Iarush/A-pad/README.md

# A-pad
A  custom Macropad with a special A-shaped keypad

## Specs
8 Mx Cherry Keys
EC11 Rotary Encoder
0.91" OLED Display
Seeed XIAO RP2040 Microcontroller
Custom-made PCB
Custom-made case and plates

## CAD Model

The Case is constructed using the sandwhich plating method. 3 plates were made. A bottom plate where screws are added, a middle frame amidst which the PCB rests, and finally a top switchplate for an aestheic look tht hides the screws.
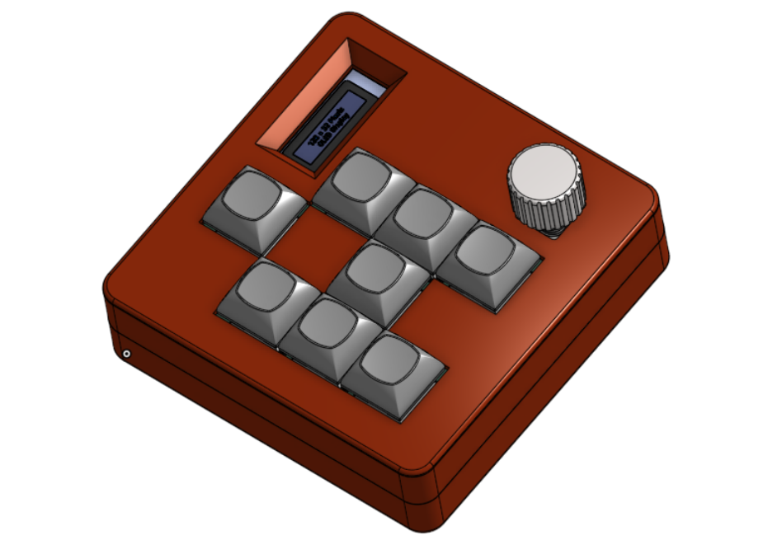
[picture p1: Images/CAD.png]
CAD Model


### Unique Features

- Switchplate is deeply bezeled aroung the OLED to allow easier viewability
- An "island" is created at the center of the A which is compeletely seperate from other parts of the switchplate but is secured with an M3 screw.
- Rotary Encoder top is also a CAD Model
CAD was made in Onshape

## PCB Schematic

The schematic was created in KICAD with the guidance of this Joe Scotto video on matrix wiring: [Video](https://www.youtube.com/watch?v=8WXpGTIbxlQ&t=787s)
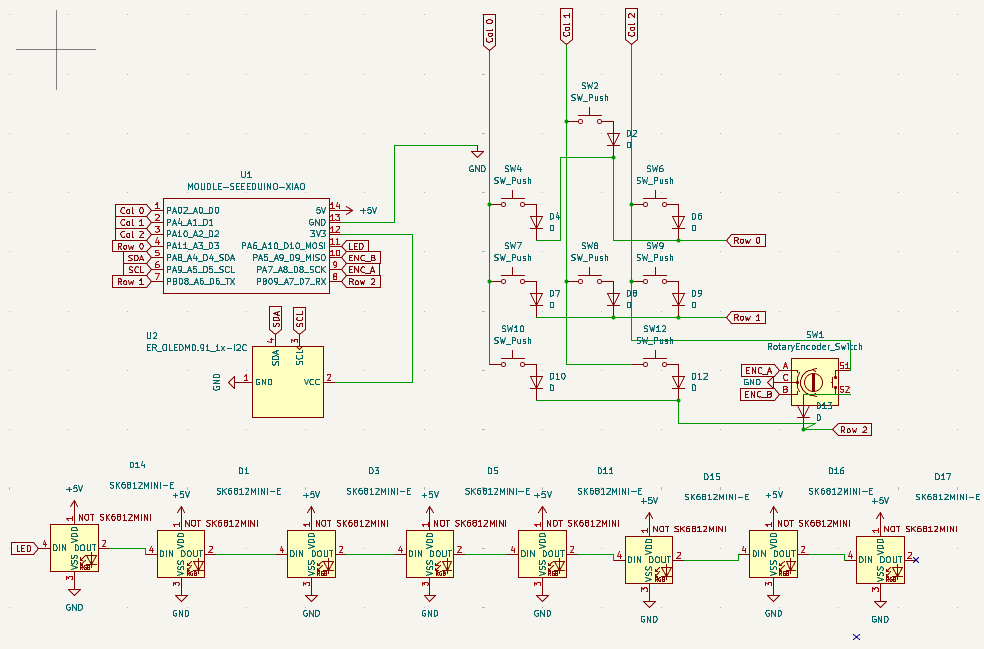
[picture p2: Images/Schematic.png]
Schematic Model


## PCB

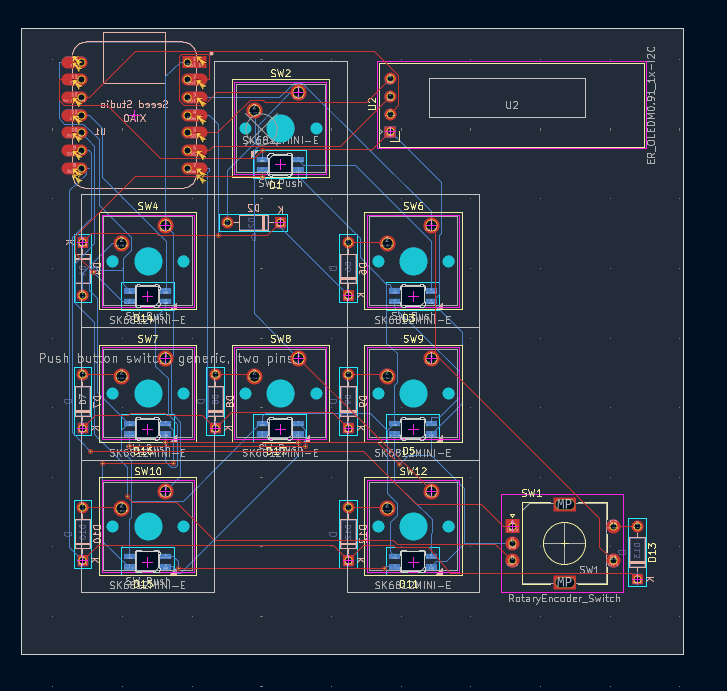
[picture p3: Images/PCB.png]
PCB Model


## Firmware Overview

This hackpad uses [KMK](https://github.com/KMKfw/kmk_firmware) firmware (CircuitPython). The firmware is [Production/main.py](Production/main.py).

- The 8 keys are wired as a 3x3 diode matrix (the encoder push button is the 9th spot)
- Keys: copy / play-pause / paste on top, undo / save / redo on the crossbar, previous / next track on the legs
- The rotary encoder changes volume, press to mute
- The 8 SK6812 MINI-E LEDs run a breathing rainbow
- The OLED shows the A-Pad name and the encoder controls
