Iarush/A-pad/BOM.csv

Item | Quantity | Component | Description / Notes | Included in HackPad Kit
1 | 1 | Seeed Studio XIAO RP2040 | Main microcontroller (U1) | Yes
2 | 1 | 0.91 inch SSD1306 OLED Display | 128x32 I2C screen (U2); pinout GND-VCC-SCL-SDA | Yes
3 | 1 | EC11 Rotary Encoder | Rotary encoder with push switch (SW1); volume control | Yes
4 | 8 | MX-Style Mechanical Switches | Keyswitches of choice (SW2/SW4/SW6-SW10/SW12) | Yes
5 | 8 | Blank DSA Keycaps | White keycaps | Yes
6 | 8 | SK6812 MINI-E RGB LEDs | Reverse-mount addressable LEDs (D1/D3/D5/D11/D14-D17) | Yes
7 | 9 | 1N4148 Diodes | Through-hole diodes for the 3x3 key matrix | Yes
8 | 6 | M3x16mm Screws | Enclosure fasteners | Yes
9 | 6 | M3x5x4mm Heatset Inserts | Brass threaded inserts for the case | Yes
10 | 1 | Custom PCB | Gerbers in Production/Gerbers.zip; ordered from JLCPCB | No
11 | 1 | 3D Printed Case | Bottom Tray / Frame / Switch Plate / Plate Island / Encoder Knob (STEP files in Production) | No
12 | 1 | Soldering Iron Station | Required for assembly (320-350 C) | No
13 | 1 | Printing Legion Grant | $8 in credit for Printing Legion | No
14 | 1 | Hackpad PCB Grant | $10 in credit for JLCPCB | No
