Iarush/A-pad/CAD/Full Assembly.step

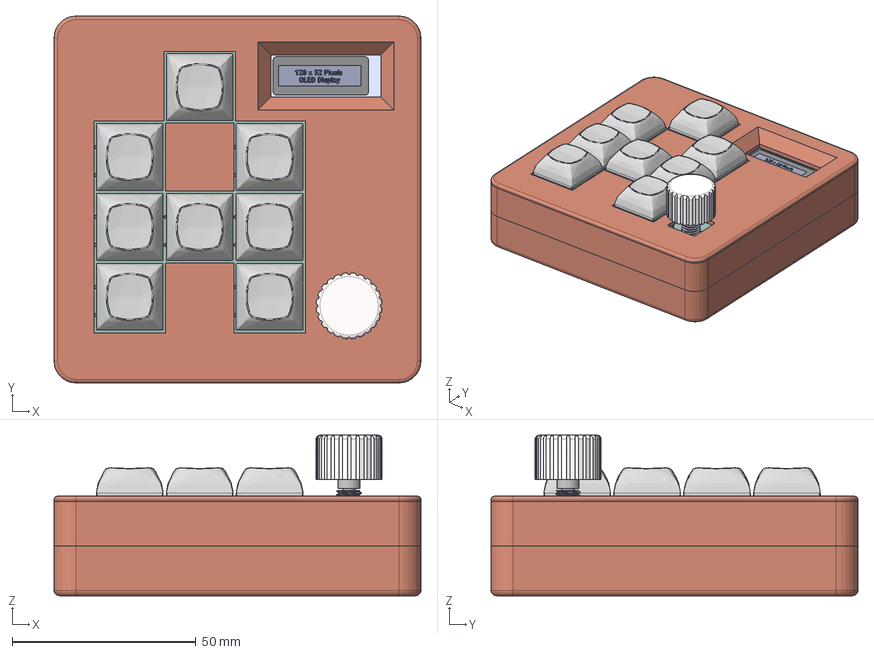
[picture p4: CAD file, 2026-10-13]
CAD/Full Assembly.step
100.0 x 100.0 x 43.7 mm
M3x16 Button Head Screw (ISO 7380) x 6
M3 Heat-Set Insert 4.7 x 4 x 6
Encoder Knob
Plate Island
Switch Plate
Frame
Bottom Tray
D_DO-35_SOD27_P7.62mm_Horizontal x 18
MX Mount v1 x 8
HackPad_PCB
Pin2 x 8
Pin4 x 8
Pin3 x 8
Pin1 x 8
EC11 v3 x 6
SW_Cherry_MX_PCB_cp x 56
smd_button v3
smd_button v3(Mirror)
DOUT
DIN
VDD
VSS
type-c v2 x 24
0603 Resistor_001 x 6
0603 Capacitor_004 x 6
0603 Capacitor_002 x 6
0603 Capacitor_005 x 6
0603 Resistor_003 x 6
0603 Resistor_005 x 6
Surface Mount Transistor_001 x 8
0603 Capacitor_008 x 6
1x4 Male Header_001 x 10
0603 Resistor_004 x 6
0603 Capacitor_001 x 6
0603 Capacitor_003 x 6
0603 Resistor_002 x 6
0603 Capacitor_006 x 6
0603 Capacitor_007 x 6
