Iarush/A-pad/Production/Switch Plate.step

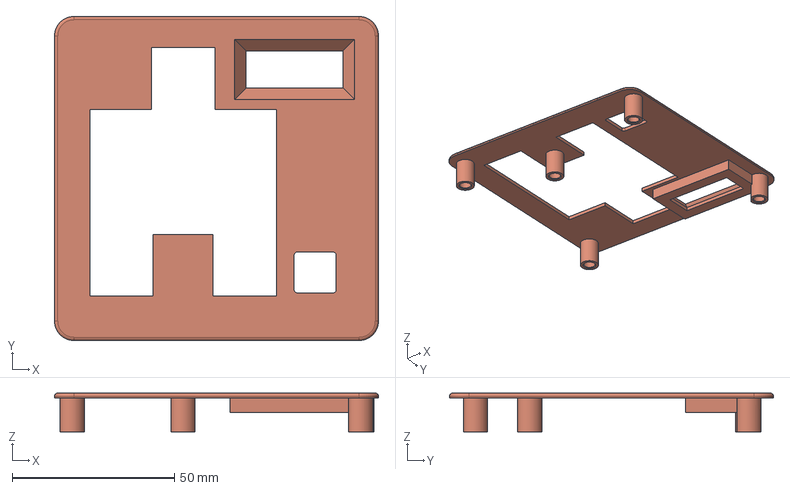
[picture p5: CAD file, 2026-11-08]
Production/Switch Plate.step
100.0 x 100.0 x 12.0 mm
