Iarush/A-pad/CAD/HackPad_with_parts.step

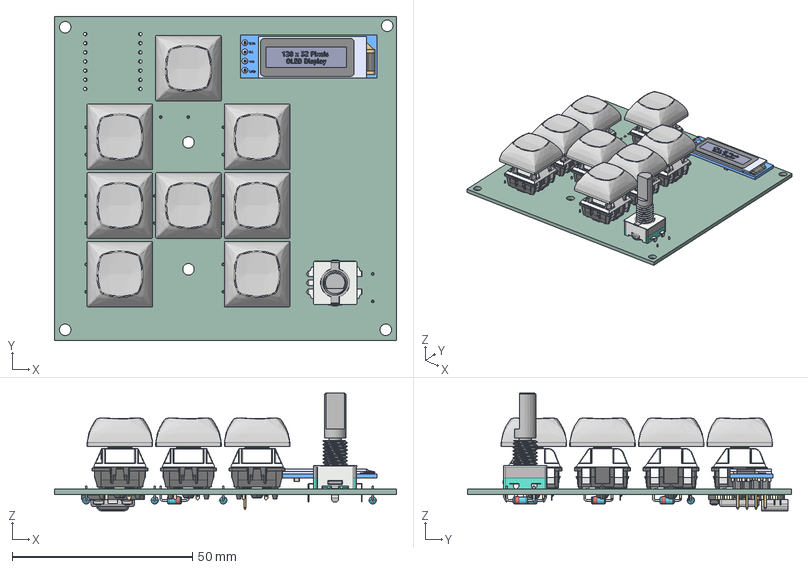
[picture p6: CAD file, 2026-10-13]
CAD/HackPad_with_parts.step
95.0 x 90.0 x 32.7 mm
SW_Cherry_MX_PCB_cp x 8
MX Mount v1 x 8
Pin1 x 8
Pin2 x 8
Pin3 x 8
Pin4 x 8
1x4 Male Header_001 x 2
0603 Capacitor_001 x 2
0603 Capacitor_002 x 2
0603 Capacitor_003 x 2
0603 Capacitor_004 x 2
0603 Capacitor_005 x 2
0603 Capacitor_006 x 2
0603 Capacitor_007 x 2
0603 Capacitor_008 x 2
0603 Resistor_001 x 2
0603 Resistor_002 x 2
0603 Resistor_003 x 2
0603 Resistor_004 x 2
0603 Resistor_005 x 2
Surface Mount Transistor_001 x 2
EC11 v3
D_DO-35_SOD27_P7.62mm_Horizontal x 9
type-c v2
smd_button v3
DOUT
DIN
VSS
VDD
smd_button v3(Mirror)
HackPad_PCB
