Iarush/A-pad/Production/Plate Island.step

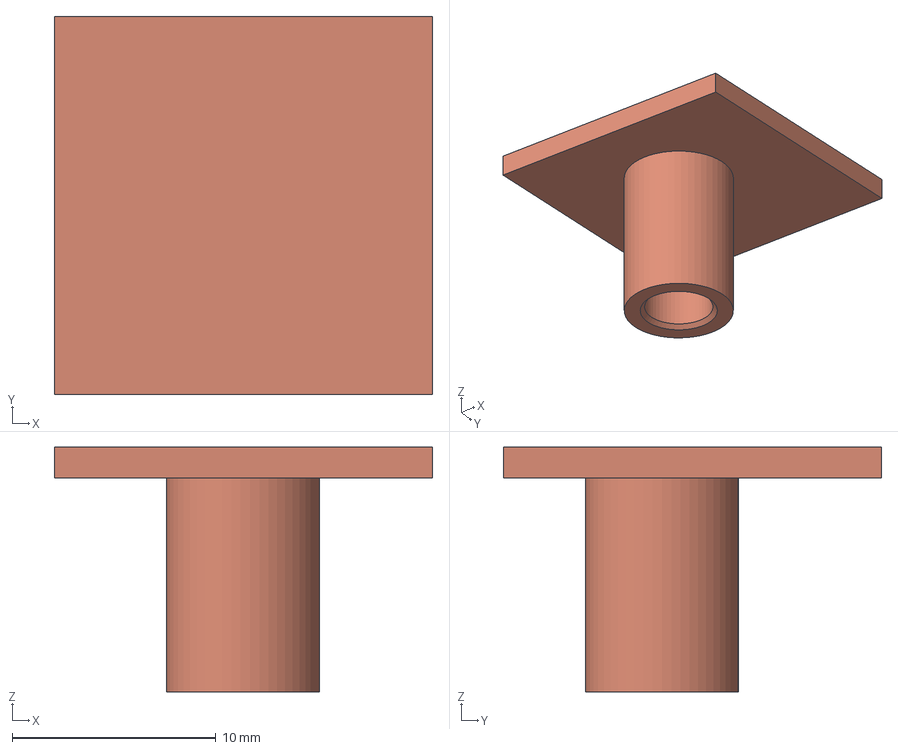
[picture p7: CAD file, 2026-11-08]
Production/Plate Island.step
18.6 x 18.6 x 12.0 mm
