Iarush/A-pad/Production/Encoder Knob.step

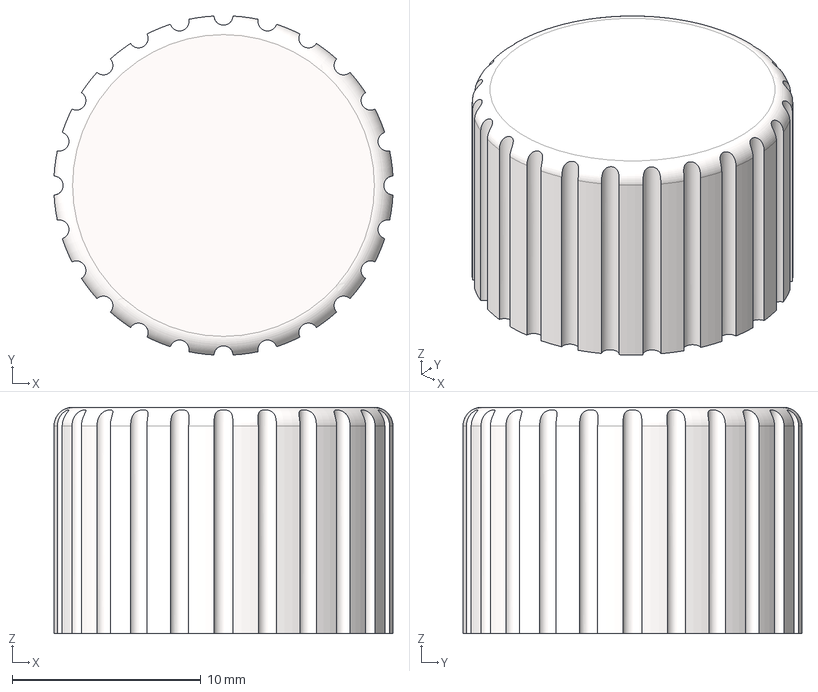
[picture p8: CAD file, 2026-11-08]
Production/Encoder Knob.step
18.0 x 18.0 x 12.0 mm
