Iarush/A-pad/Production/Bottom Tray.step

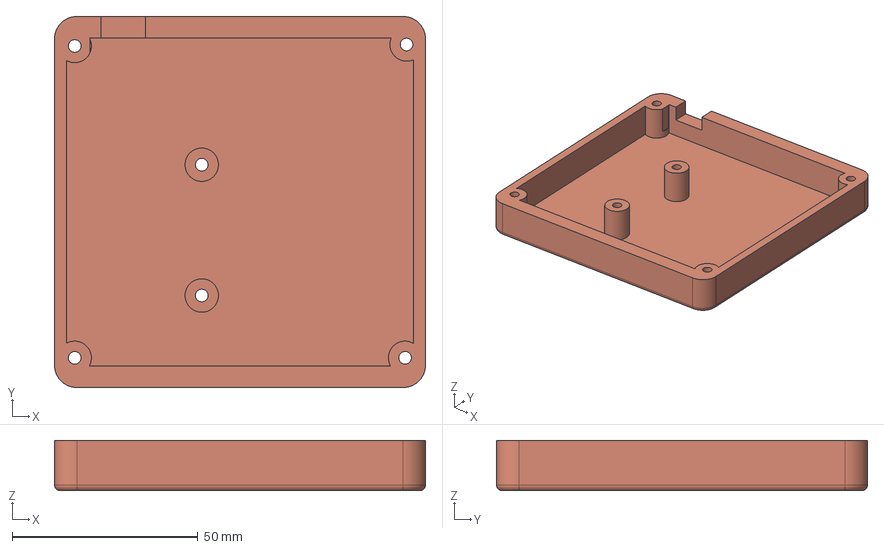
[picture p9: CAD file, 2026-11-08]
Production/Bottom Tray.step
100.0 x 100.0 x 13.5 mm
