Iarush/A-pad/Production/Frame.step

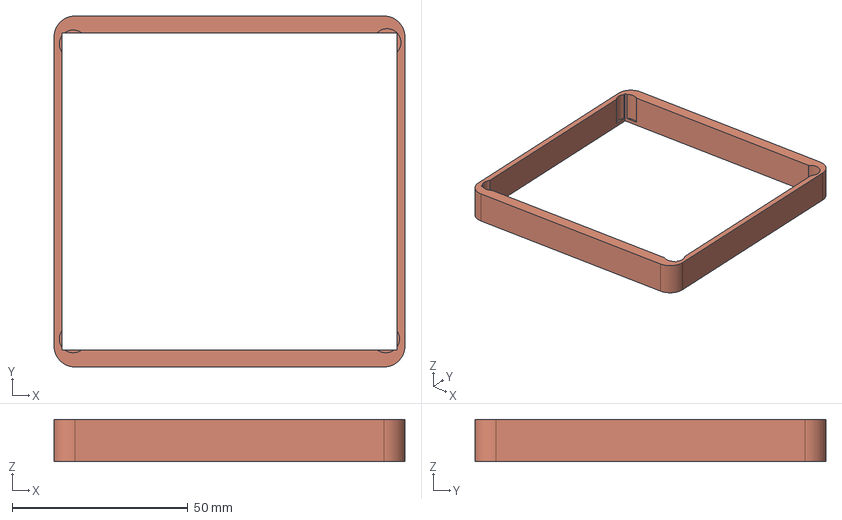
[picture p10: CAD file, 2026-11-08]
Production/Frame.step
100.0 x 100.0 x 12.1 mm
