Iarush/A-pad/PCB/HackPad.kicad_pcb

## KiCad design PCB/HackPad.kicad_pcb (2026-11-09)

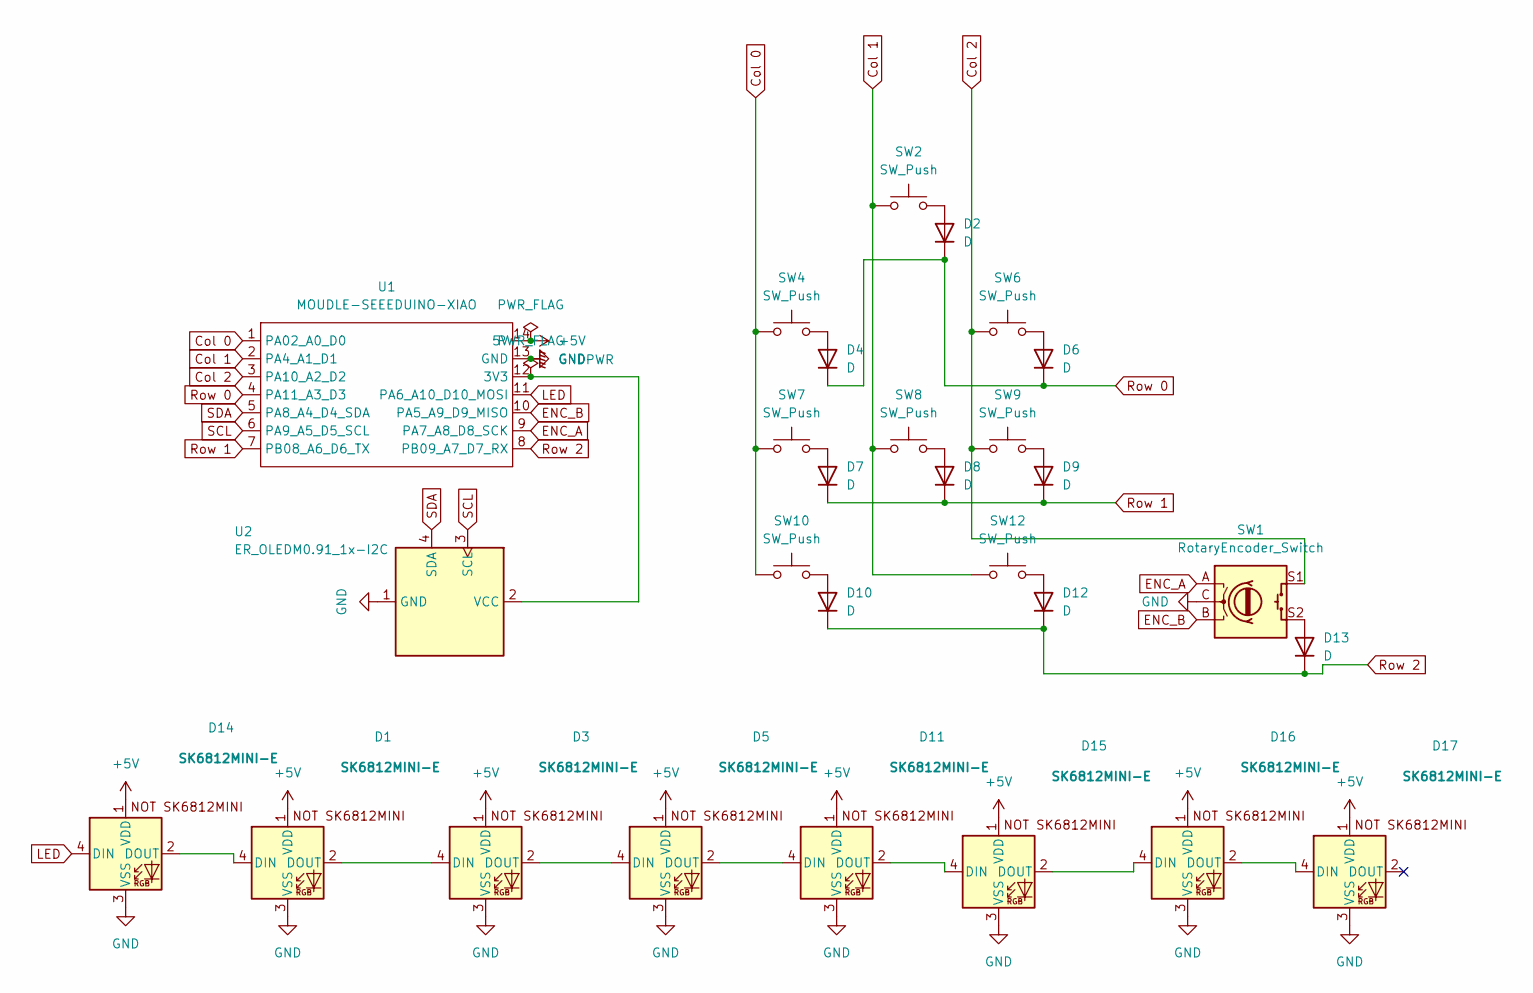
[picture p11: schematic HackPad.kicad_sch]

Parts:
D1, D3, D5, D11, D14, D15, D16, D17: SK6812MINI-E; SK6812MINI-E_fixed
D2, D4, D6, D7, D8, D9, D10, D12, D13: D; D_DO-35_SOD27_P7.62mm_Horizontal
SW1: RotaryEncoder_Switch; RotaryEncoder_Alps_EC11E-Switch_Vertical_H20mm
SW2, SW4, SW6, SW7, SW8, SW9, SW10, SW12: SW_Push; SW_Cherry_MX_1.00u_PCB
U1: MOUDLE-SEEEDUINO-XIAO; XIAO-Generic-Hybrid-14P-2.54-21X17.8MM
U2: ER_OLEDM0.91_1x-I2C

Connections:
+5V: D1.1 (VDD), D3.1 (VDD), D5.1 (VDD), D11.1 (VDD), D14.1 (VDD), D15.1 (VDD), D16.1 (VDD), D17.1 (VDD), U1.14 (5V)
Col 0: SW4.1, SW7.1, SW10.1, U1.1 (PA02_A0_D0)
Col 1: SW2.1, SW8.1, SW12.1, U1.2 (PA4_A1_D1)
Col 2: SW1.S1, SW6.1, SW9.1, U1.3 (PA10_A2_D2)
ENC_A: SW1.A, U1.9 (PA7_A8_D8_SCK)
ENC_B: SW1.B, U1.10 (PA5_A9_D9_MISO)
GND: D1.3 (VSS), D3.3 (VSS), D5.3 (VSS), D11.3 (VSS), D14.3 (VSS), D15.3 (VSS), D16.3 (VSS), D17.3 (VSS), SW1.C, U1.13 (GND), U2.1 (GND)
LED: D14.4 (DIN), U1.11 (PA6_A10_D10_MOSI)
unnamed: D1.4 (DIN), D14.2 (DOUT)
unnamed: D1.2 (DOUT), D3.4 (DIN)
unnamed: D2.2 (A), SW2.2
unnamed: D3.2 (DOUT), D5.4 (DIN)
unnamed: D4.2 (A), SW4.2
unnamed: D6.2 (A), SW6.2
unnamed: D7.2 (A), SW7.2
unnamed: D8.2 (A), SW8.2
unnamed: D9.2 (A), SW9.2
unnamed: D10.2 (A), SW10.2
unnamed: D5.2 (DOUT), D11.4 (DIN)
unnamed: D11.2 (DOUT), D15.4 (DIN)
unnamed: D12.2 (A), SW12.2
unnamed: D13.2 (A), SW1.S2
unnamed: D15.2 (DOUT), D16.4 (DIN)
unnamed: D16.2 (DOUT), D17.4 (DIN)
unnamed: U1.12 (3V3), U2.2 (VCC)
Row 0: D2.1 (K), D4.1 (K), D6.1 (K), U1.4 (PA11_A3_D3)
Row 1: D7.1 (K), D8.1 (K), D9.1 (K), U1.7 (PB08_A6_D6_TX)
Row 2: D10.1 (K), D12.1 (K), D13.1 (K), U1.8 (PB09_A7_D7_RX)
SCL: U1.6 (PA9_A5_D5_SCL), U2.3 (SCL)
SDA: U1.5 (PA8_A4_D4_SDA), U2.4 (SDA)

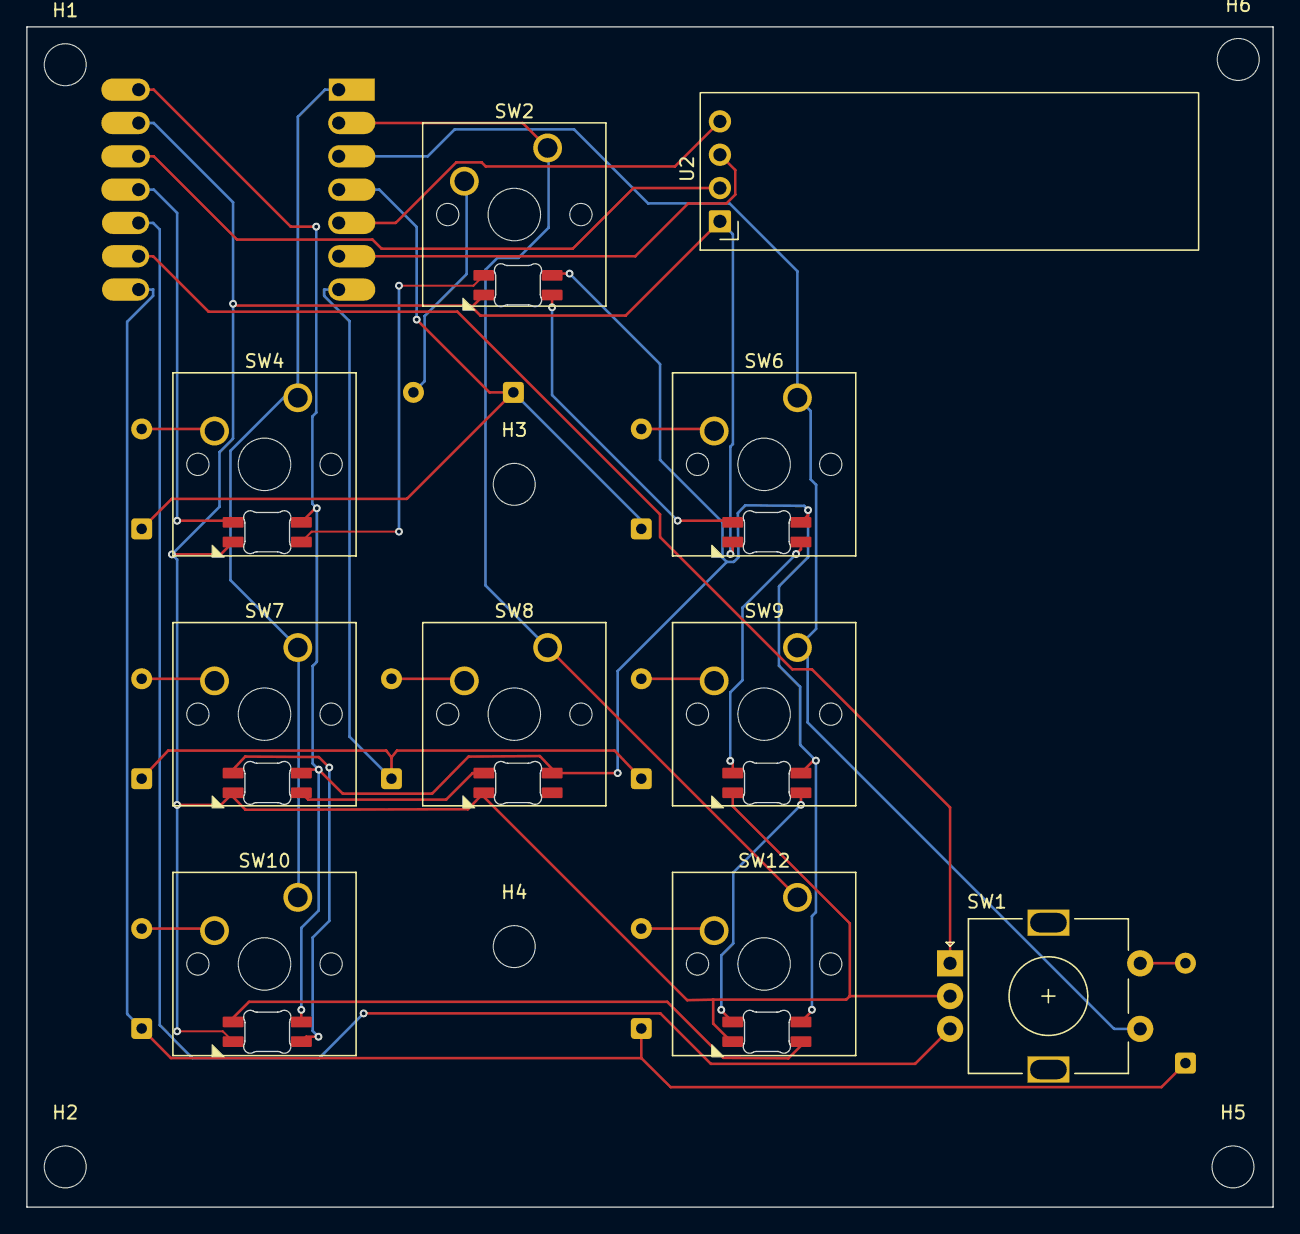
[picture p12: board HackPad.kicad_pcb from above]

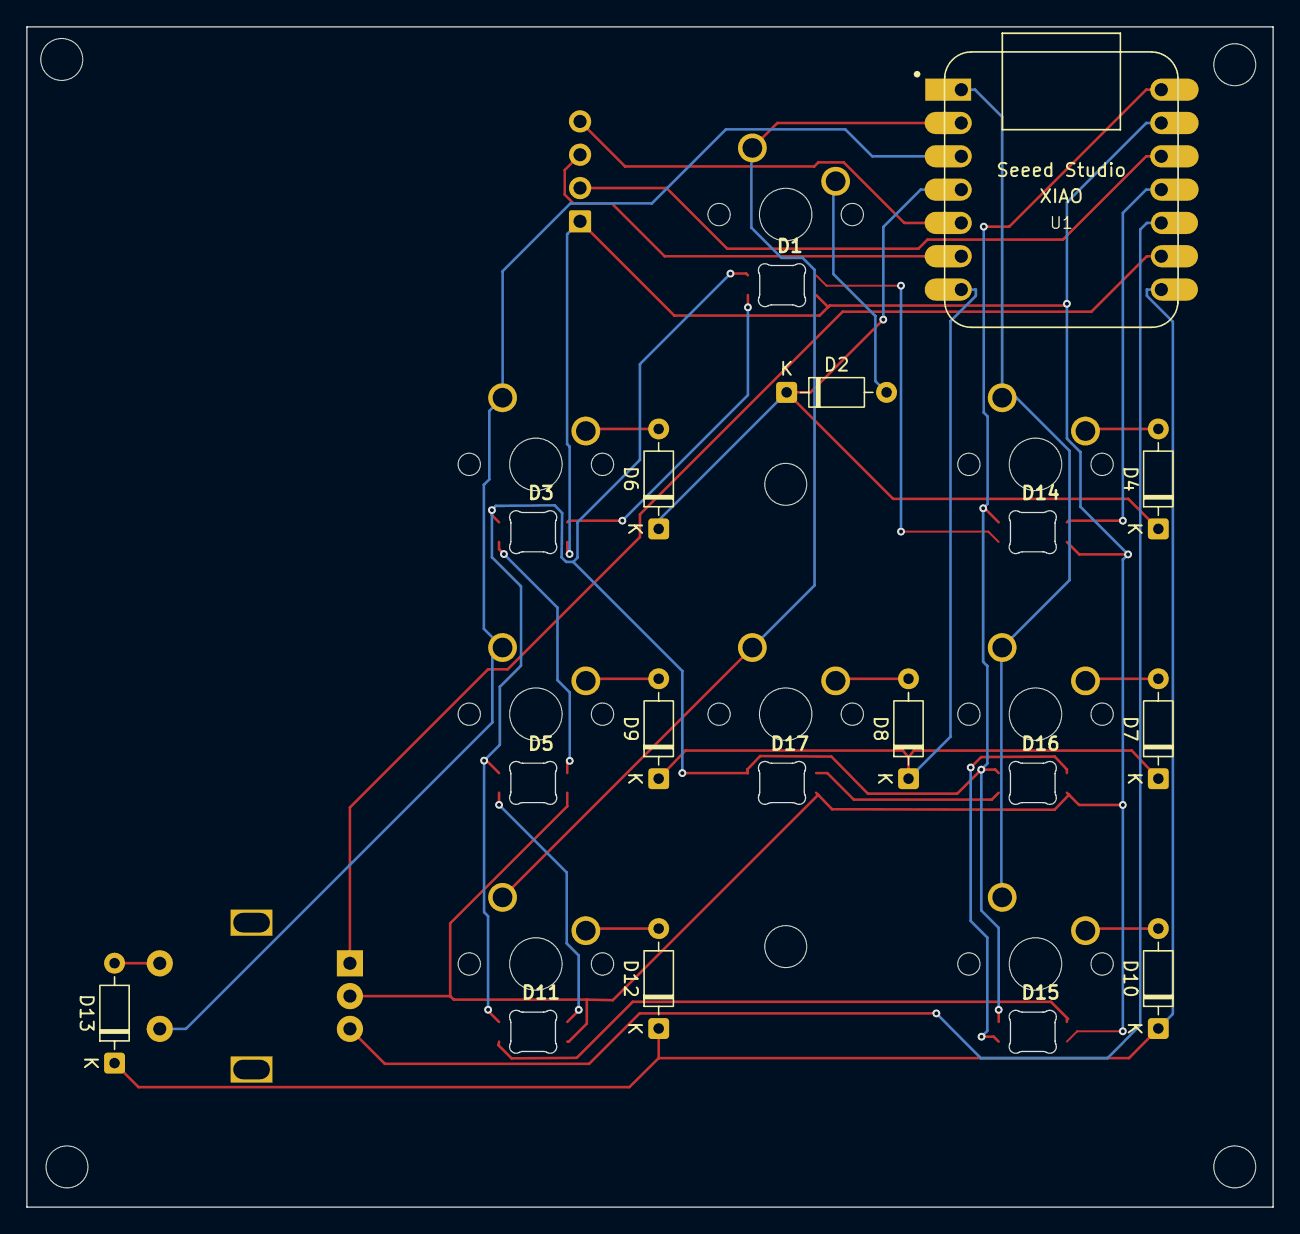
[picture p13: board HackPad.kicad_pcb from below]

Board: 2 copper layers, 95.0 x 90.0 mm, 34 parts (18 on the bottom side), 30 nets.

Other parts of the board:
H1, H2, H3, H4, H5, H6: MountingHole; MountingHole_3.2mm_M3
