Iarush/A-pad/(commit log)

2026-10-13 PCB Files Upload
    [HackPad.kicad_sch, HackPad_with_parts.step]
2026-10-13 Added CAD
    [Bottom Tray.stl, Encoder Knob.stl, Frame.stl, Full Assembly.step, HackPad.kicad_sch, HackPad_with_parts.step, Plate Island.stl, Switchplate.stl]
2026-10-13 Edited Bottom Tray
    [Assembly 1.stl, Bottom Tray.stl, Full Assembly.step]
2026-10-13 Changed CAD tolerances
    [Assembly 1.stl, Encoder Knob.stl, Frame.stl, Full Assembly.step, HackPad_with_parts.step, Plate Island.stl, Switch Plate.stl, Switchplate.stl]
2026-11-08 Funding Updates
    [BOM.csv, Bottom Tray.step, Bottom Tray.stl, Encoder Knob.step, Encoder Knob.stl, Frame.step, Frame.stl, Plate Island.step]
2026-11-08 image fixes
    [BOM.csv]
2026-11-08 BOM changes
    [BOM.csv]
2026-11-09 Adding .pcb
    [HackPad.kicad_pcb]
